tuna-f1sh/nixiepipe-hardware/README.md

# Nixie Pipe Hardware



This repository contains design files for my [Nixie
Pipe](http://www.nixiepipe.com) modules. Contained with:

* OpenSCAD mechanical design script.
* KiCAD PCB design
* Arduino/C++ firmware

## Supporting Repositories

* [Arduino Library](https://github.com/tuna-f1sh/NixiePipe)
* [Node module](https://github.com/tuna-f1sh/node-nixiepipe)
* [Python Package](https://github.com/tuna-f1sh/py-nixiepipe)
* [Electron GUI app](https://github.com/tuna-f1sh/electron-nixiepipe)

## Supporting the Project and Attribution

If you do make your own Nixie Pipe and wish to offer some gratitude, please
feel free to donate any amount to me using the button at the top of the
repository.

**Software** is 

**Hardware (KiCad, OpenSCAD, design exports etc.)** is 

I make many of my projects Open Source so others can learn as I have, but please remember
to follow the license terms and attribute any derivations or code reuse.
Please link back to the project, [www.nixiepipe.com](www.nixiepipe.com) and
[www.jbrengineering.co.uk](www.jbrengineering.co.uk).
