tuna-f1sh/nixiepipe-hardware/nixie-pipe-pcb.stl

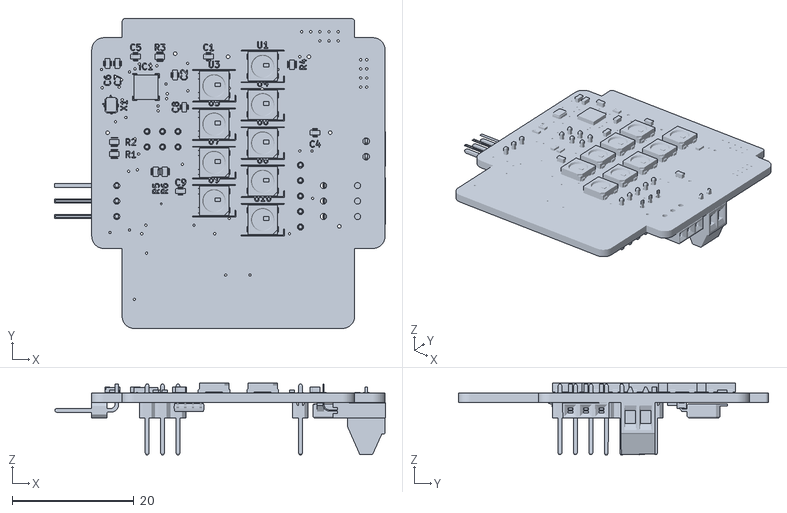
[picture p1: CAD file, 2016-08-11]
nixie-pipe-pcb.stl
54.4 x 50.9 x 11.8
