tuna-f1sh/nixiepipe-hardware/pcb/kicad/nixie-pipe.pdf

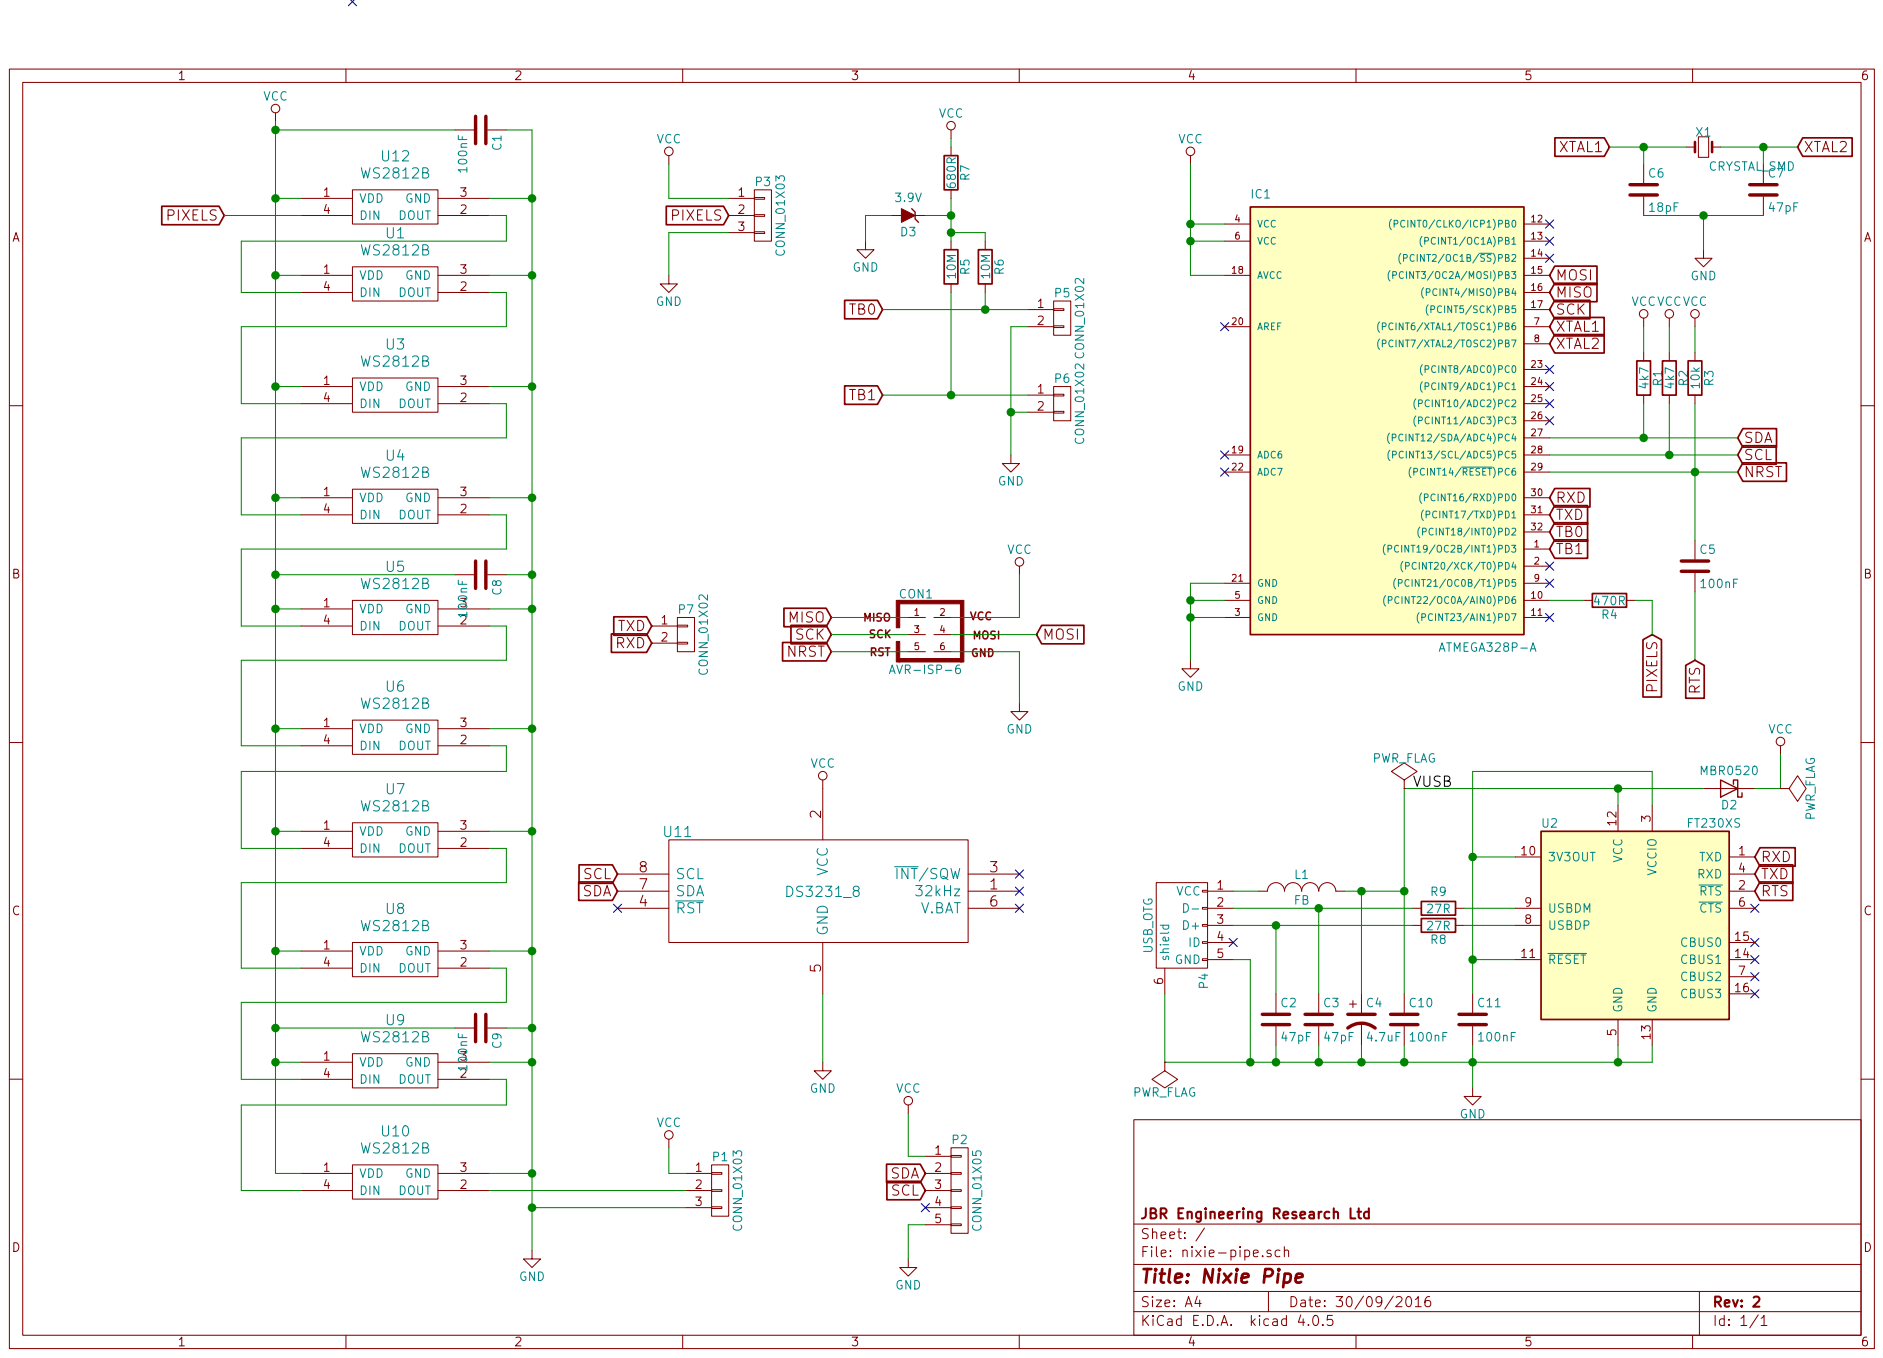
[picture p2: page 1]

Id: 1/1 Title: Nixie Pipe
