tuna-f1sh/nixiepipe-hardware/(commit log)

2016-07-30 First prototype; width and led contact point needs adjustment
    [laser-functions.scad, nixiepipe-base.dxf, nixiepipe-front.dxf, nixiepipe-numbers.dxf, nixiepipe-rear.dxf, nixiepipe-side.dxf, nixiepipe.scad, shapes.scad]
2016-08-05 Width now properly scales; WS2812 alternates about center; First PCB draft complete
    [nixie-pipe.kicad_pcb, nixie-pipe.sch, nixiepipe.scad]
2016-08-11 PCB 1.0 to CEM. Mechanical changes.¬
    * PCB features tabs for fixing and touch button.¬
    * Slots in front/rear housing for PCB tabs.¬
    * Option for screw fixings rather than dent/tooth enclosure.¬
    * General OpenSCAD script improvements¬
    [nixie-pipe.kicad_pcb, nixie-pipe.sch, nixiepipe-front.dxf, nixiepipe-numbers.dxf, nixiepipe-rear.dxf, nixiepipe-side.dxf, nixiepipe.scad]
2016-08-11 X1 replaced with 5032 for handsoldering cost saving
    [nixie-pipe-pcb.stl, nixie-pipe.kicad_pcb, nixie-pipe.sch]
2016-08-22 Stack numbers from other end;script optimisations
    [nixiepipe-base.dxf, nixiepipe-front.dxf, nixiepipe-numbers.dxf, nixiepipe-rear.dxf, nixiepipe-side.dxf, nixiepipe.scad]
2016-08-24 Replaced Atmega328 QFN28 with Attiny84 SOIC14;screw you QFN
    [nixie-pipe.kicad_pcb, nixie-pipe.sch]
2016-08-24 Added WS2812B U12 for zero :S
    [nixie-pipe.kicad_pcb, nixie-pipe.sch]
2016-08-24 Library finialised and example sketches added
    [nixiepipe.scad]
2016-08-25 Library removed from this repo and separate one made. Rear slot for PCB made slightly bigger
    [nixiepipe.scad]
2016-08-26 Added strain relief holes to rear and no tab option for PCB
    [nixiepipe.scad]
2016-08-31 squeezed atmega328 TQFP32 package onto board and regulator corrected to TO-263
    [nixie-pipe.kicad_pcb, nixie-pipe.sch]
2016-09-01 Top WS2812B shifter up slightly
    [nixie-pipe.kicad_pcb]
2016-09-04 Extra silkscreen notation added to IO
    [nixie-pipe.kicad_pcb]
2016-09-09 Added BOM files for parts
    [nixie-pipe.sch]
2016-09-13 MATZ reduced 0.04mm for actual acrylic thickness, -0.1mm PCB outline
    [nixiepipe.scad]
2016-09-22 Linear regulator removed in favour of SMPS wall wort 5V
    [nixie-pipe.kicad_pcb, nixie-pipe.sch, nixiepipe.scad]
2016-10-01 Micro-B USB added for power and IO, reg removed
    [nixie-pipe.kicad_pcb, nixie-pipe.sch, nixiepipe.scad]
2016-10-07 Boards file added for PCB and Makefile changes
    [nixiepipe.scad]
2016-10-19 Correctly selected crystal capcitors for load capcacitance
    [nixie-pipe.sch, nixiepipe.scad]
2016-10-21 FT230XS added rather than D+/- to pins and VUSB
    [nixie-pipe.kicad_pcb, nixie-pipe.sch]
2016-10-23 Locking nodes updated to allow swing into position
    [nixiepipe.scad]
2016-10-23 Logo added to PCB and shortened by 1mm for tool
    [nixie-pipe.kicad_pcb, nixiepipe.scad]
2016-10-23 Overvoltage protection zener added to VCC
    [nixie-pipe.kicad_pcb, nixie-pipe.sch]
2016-10-31 Added serial interrupter firmware
2016-11-07 Python package work
    [nixie-pipe.kicad_pcb, nixiepipe.scad]
2016-11-18 Acrylic depth REDUCED 0.1 (1mm delta), LEDs moved too
    Acrylic depth is 3.1mm, resulting in 1mm reduction in total depth. Not
    just board edge changed but LED position shifted down also for first
    time. NEEDS VERIFICATION.
    [nixie-pipe.csv, nixie-pipe.kicad_pcb, nixie-pipe.sch, nixiepipe.scad]
2016-12-04 Python package moved to separate repo
    [nixie-pipe.csv]
2016-12-04 Strain relief added to front layer like rear
    [nixiepipe.scad]
2016-12-14 Updates to firmware license and spacing for PCB on front panel
    [nixiepipe.scad]
2016-12-14 Licensing update
    [nixiepipe.scad]
2017-01-08 3V clamp on touch input to bring to LHV threshold
    [nixie-pipe.csv, nixie-pipe.kicad_pcb, nixie-pipe.sch]
2017-01-08 Serial mode added to clock; State machine in header file
    [nixiepipe.scad]
2017-01-16 Release for PCA with silkscreen
    [nixie-pipe.kicad_pcb, nixie-pipe.sch]
2017-03-10 Lib updates and schmatic pdf export
    [laser-functions.scad, nixie-pipe.kicad_pcb, nixie-pipe.sch, shapes.scad]
2017-03-17 Added connect detect to clock firmare start up and version display
    Delay at boot (1.5s) whilst serial poll for connect message allows the
    PCB with RTS to reset on connect and still work. Added benefit of
    version display during this period
    [np-clock.ino, np-serial.ino, serial.h]
2017-04-11 Increased startup delay for connection
    [nixiepipe.scad]
2017-06-15 README update
    [nixie-pipe.kicad_pcb]
2017-09-03 Hardware now CC-BY-SA 4.0, BOM changes supply to CEM
    [nixie-pipe.kicad_pcb, nixie-pipe.sch, nixiepipe.scad]
2017-09-30 Correct 100 uF(n) typo and standardise 0.1 uF 100 nF
    [nixie-pipe.kicad_pcb, nixie-pipe.sch]
2018-12-21 Set units and correct number of pipes
    [np-weather.ino]
2018-12-21 KiCad updates for 5.0
    [nixie-pipe.sch, nixiepipe.scad]
2019-11-28 tapped rear panel rather than stud and mech tweaks
    [nixiepipe.scad]
