tuna-f1sh/nixiepipe-hardware/(notices)

Notices in the files:
firmware/np-clock/np-clock.ino:
This program is free software: you can redistribute it and/or modify
it under the terms of the GNU General Public License as published by
the Free Software Foundation, either version 3 of the License, or
(at your option) any later version.
README.md:
License: GPL v3
License: CC BY-SA 4.0
